maxaksel/HandTracker/README.md

# HandTracker

Project members: Max Bowman and Josh Stidham

This repository contains Eagle hardware files and C software files for
our final project.

Simulink navigation equation blocks used for visualization courtesy of Christopher Lum (University of Washington).
