maxaksel/HandTracker/eagle/HandTracker/HandTracker.brd

## EAGLE design eagle/HandTracker/HandTracker.brd (2022-04-10)

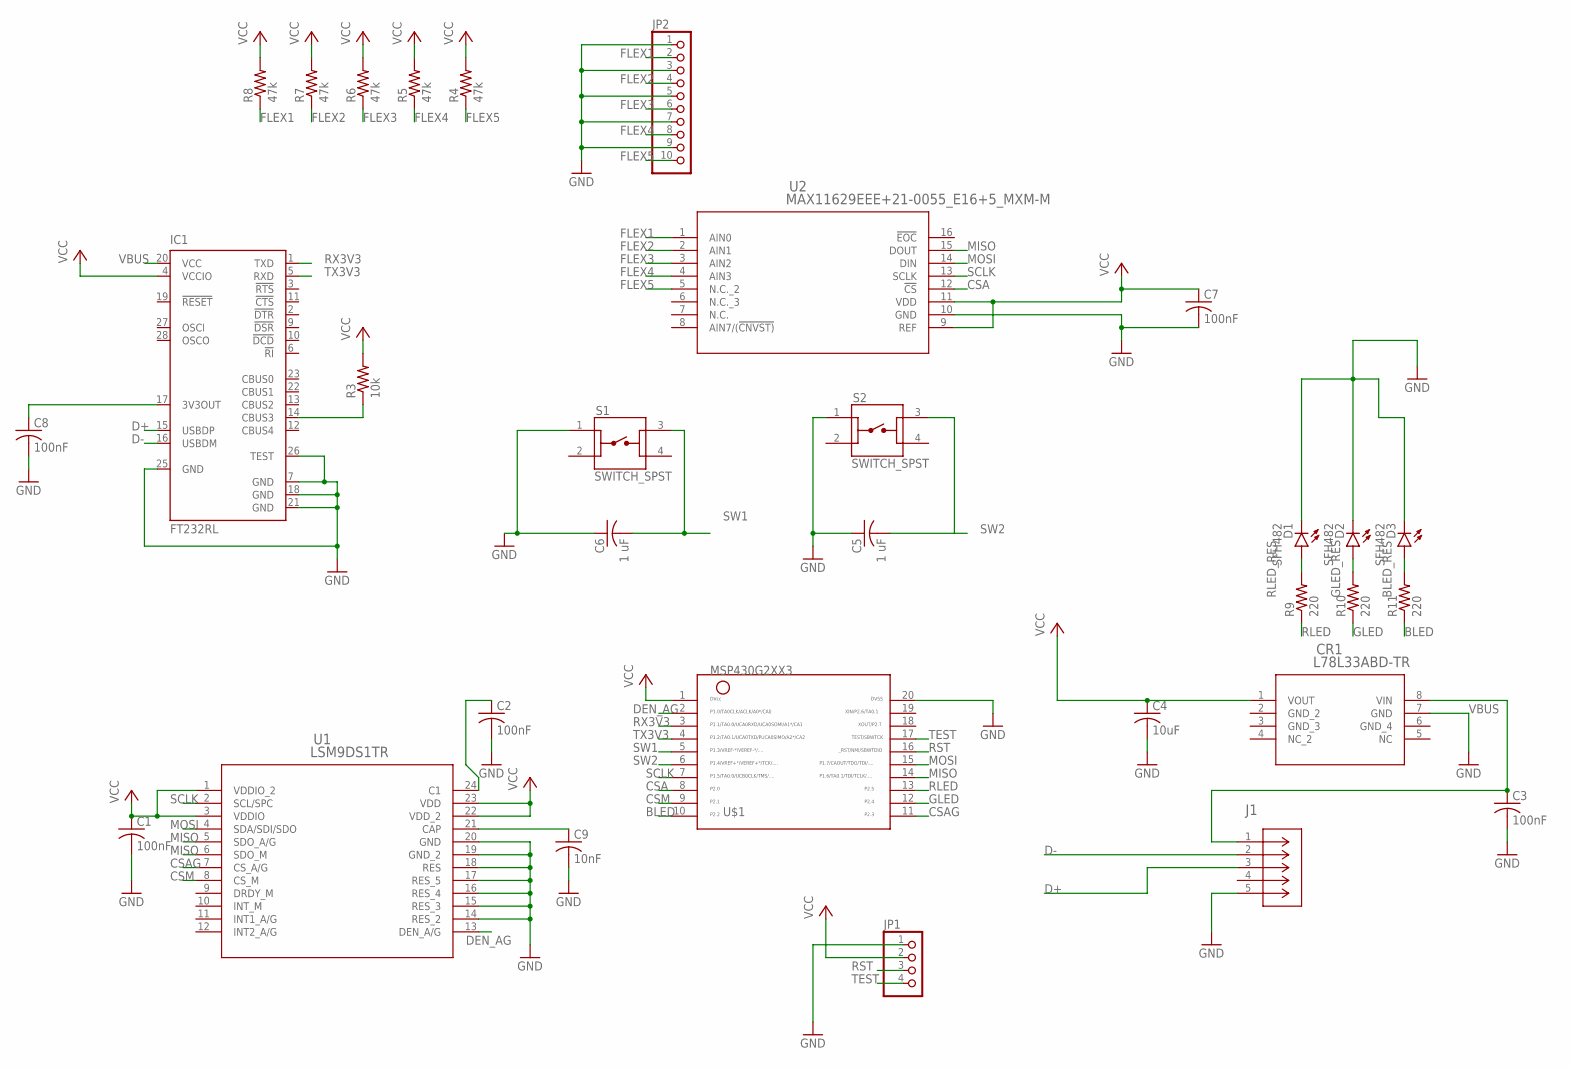
[picture p1: schematic HandTracker.sch]

Parts:
C1, C2, C3, C7, C8: 100nF; C1206
C4: 10uF; C1206
C5, C6: 1 uF; C1206
C9: 10nF; C1206
CR1: L78L33ABD-TR; SO-8_STM
D1, D2, D3: SFH482
IC1: FT232RL; SSOP28
J1: ZX62-AB-5PA(31); CONN5_ZX62-AB-5PA_HIR
JP1: PINHD-1X4/90; 1X04/90
JP2: PINHD-1X10; 1X10
R3: 10k; R1206
R4, R5, R6, R7, R8: 47k; R1206
R9, R10, R11: 220; R1206
S1, S2: SWITCH_SPST; SW_1825910-7
U1: LSM9DS1TR; LGA-24_3X3P5X1_STM
U2: MAX11629EEE+21-0055_E16+5_MXM-M; 21-0055_E16+5_MXM-M
U$1: MSP430G2XX3TSSOP; PW20

Connections:
BLED: R11.1, U$1.10
BLED_RES: D3.A, R11.2
CSA: U2.12 (!CS), U$1.8
CSAG: U1.7 (CS_A/G), U$1.11
CSM: U1.8 (CS_M), U$1.9
D+: IC1.15 (USBDP), J1.3 (D+)
D-: IC1.16 (USBDM), J1.2 (D-)
DEN_AG: U1.13 (DEN_A/G), U$1.2
FLEX1: JP2.2, R8.1, U2.1 (AIN0)
FLEX2: JP2.4, R7.1, U2.2 (AIN1)
FLEX3: JP2.6, R6.1, U2.3 (AIN2)
FLEX4: JP2.8, R5.1, U2.4 (AIN3)
FLEX5: JP2.10, R4.1, U2.5 (N.C._2)
GLED: R10.1, U$1.12
GLED_RES: D2.A, R10.2
GND: C1.2, C2.2, C3.2, C4.2, C5.1, C6.1, C7.2, C8.2, C9.2, CR1.7 (GND), D1.K (C), D2.K (C), D3.K (C), IC1.7 (GND), IC1.18 (GND), IC1.21 (GND), IC1.25 (GND), IC1.26 (TEST), J1.5 (GND), JP1.1, JP2.1, JP2.3, JP2.5, JP2.7, JP2.9, S1.1, S2.1, U1.14 (RES_2), U1.15 (RES_3), U1.16 (RES_4), U1.17 (RES_5), U1.18 (RES), U1.19 (GND_2), U1.20 (GND), U2.10 (GND), U$1.20
MISO: U1.5 (SDO_A/G), U1.6 (SDO_M), U2.15 (DOUT), U$1.14
MOSI: U1.4 (SDA/SDI/SDO), U2.14 (DIN), U$1.15
unnamed: C2.1, U1.24 (C1)
unnamed: C8.1, IC1.17 (3V3OUT)
unnamed: IC1.14 (CBUS3), R3.1
unnamed: C9.1, U1.21 (CAP)
RLED: R9.1, U$1.13
RLED_RES: D1.A, R9.2
RST: JP1.3, U$1.16
RX3V3: IC1.1 (TXD), U$1.3
SCLK: U1.2 (SCL/SPC), U2.13 (SCLK), U$1.7
SW1: C6.2, S1.3, U$1.5
SW2: C5.2, S2.3, U$1.6
TEST: JP1.4, U$1.17
TX3V3: IC1.5 (RXD), U$1.4
VBUS: C3.1, CR1.8 (VIN), IC1.20 (VCC), J1.1 (VCC)
VCC: C1.1, C4.1, C7.1, CR1.1 (VOUT), IC1.4 (VCCIO), JP1.2, R3.2, R4.2, R5.2, R6.2, R7.2, R8.2, U1.1 (VDDIO_2), U1.3 (VDDIO), U1.22 (VDD_2), U1.23 (VDD), U2.9 (REF), U2.11 (VDD), U$1.1

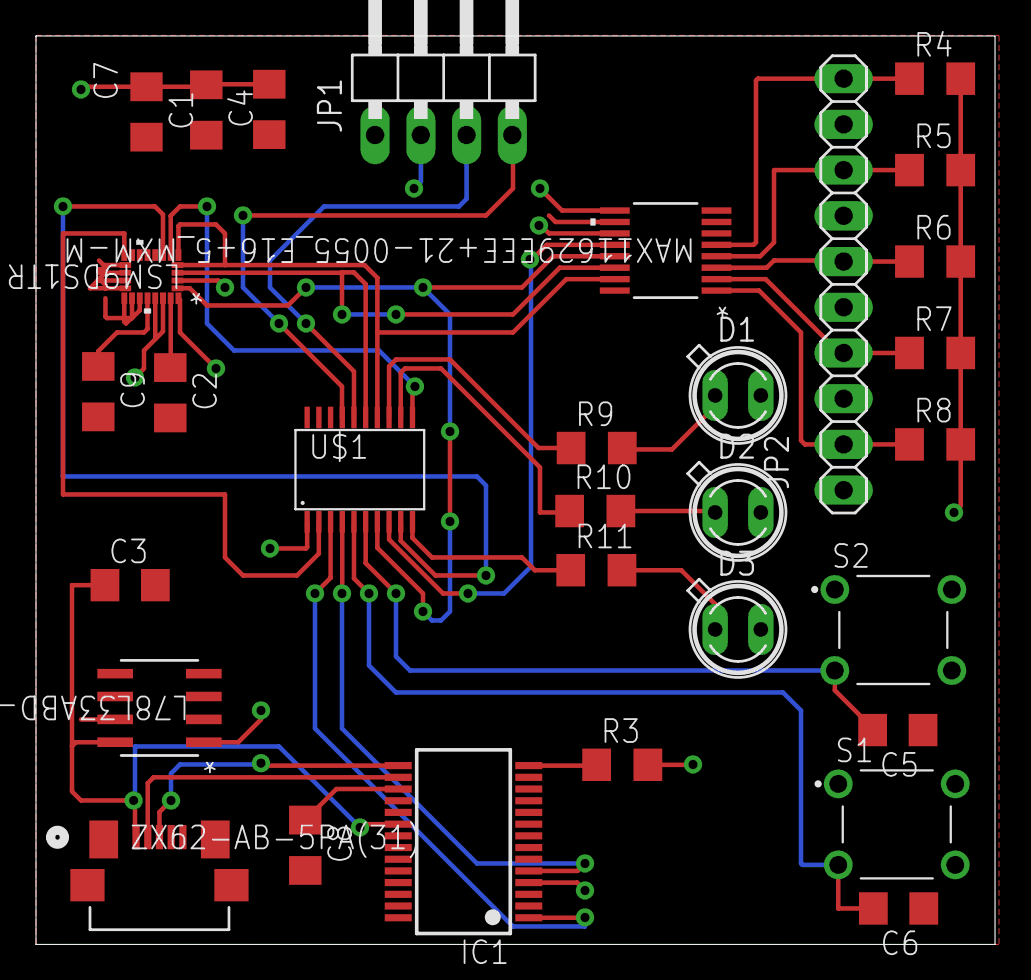
[picture p2: board HandTracker.brd from above]

Board: 2 copper layers, 53.3 x 50.5 mm, 31 parts (0 on the bottom side), 33 nets.
