maxaksel/HandTracker/serial.h

/*
 * serial.h
 *
 *  Created on: Apr 24, 2022
 *      Author: joshs
 */

#include <stdint.h>
#include <stdbool.h>
#include <msp430.h>

#include "spi.h"
#include "uart.h"


#ifndef SERIAL_H_
#define SERIAL_H_










#endif /* SERIAL_H_ */
