maxaksel/HandTracker/(commit log)

2022-04-04 Added Project Structure
    [HandTracker.sch]
2022-04-04 Started Adding Components to Schematic
    [HandTracker.sch]
2022-04-07 Started Populating Schematic with ICs
    [HandTracker.sch]
2022-04-07 Continued Populating Schematic and began making connections
    [HandTracker.sch]
2022-04-07 continued making connections
    [HandTracker.sch]
2022-04-07 completed connections for all components except FT232
    [HandTracker.sch]
2022-04-07 added FT232RL, still need to add LED
    [HandTracker.sch]
2022-04-08 added led, completed schematic
    [HandTracker.sch]
2022-04-08 updated passive component values to reflect recommended operating conditions for various ICs
    [HandTracker.sch]
2022-04-08 removed USB termination resistors
    [HandTracker.sch]
2022-04-08 Changed linear voltage regulator.
    [HandTracker.sch]
2022-04-08 Add board file.
    [HandTracker.brd]
2022-04-09 Board routing minus VDD and GND planes.
    [HandTracker.brd]
2022-04-09 Draft 1 PCB with GND and VCC planes.
    [HandTracker.brd]
2022-04-10 Fix LED and route planes.
    [HandTracker.brd, HandTracker.sch]
2022-04-10 replaced rgb led with three LEDs
    [HandTracker.sch]
2022-04-10 Routed LEDs and fixed clearance issues.
    [HandTracker.brd]
2022-04-10 Add machining files generated with CAM job.
    [HandTracker.GBL, HandTracker.GTL]
2022-04-11 Button and LED IO software.
2022-04-13 Timer A interrupt code.
2022-04-18 rough code with some basic SPI functions
2022-04-22 LSM9DS1 SPI code.
2022-04-23 added files for SPI, SYSTEM (for later use), test (also for later use)
2022-04-24 updated spi API to be clearer, added uart files. Both untested
2022-04-24 Fixed + tested SPI async functions
    [main.c, spi.c, spi.h, uart.c, uart.h]
2022-04-24 minor changes to UART API, need to make more significant changes to structure of Interrupt handlers
2022-04-24 added two spi functions to switc between ADC + LSM9DS1, tested with main
2022-04-25 created serial file with combined UART + SPI ISRs, tested UART with FTDI232 chip
2022-04-28 UC0 RX Interrupt now declares SPI transmission to be complete if buffer is overrun
2022-04-28 Flight simulator and MATLAB read code. LSM9DS1 and resistor ADC code.
2022-04-29 began implementing main.c, modified timer code for use in this device (removed SW divider), changed SPI, UART baud rates, and modified button code for polling
2022-04-29 updated resistor function prototypes and continued system integration in main.c
2022-04-29 Matlab sensor fusion update.
2022-04-29 added volatile keyword to global vars modified by interrupts
2022-04-29 Add sensor fusion algorithm. Add custom glove Simulink block.
2022-04-29 Modified code to read resistors in MATLAB from packet properly
2022-04-30 reimplemented Kalman filter
2022-04-30 fixed timing, LEDs, and got Kalman filter working in MATLAB
    [led.c, timera0.c]
2022-05-01 Add IMU calibration mats. Add magnetometer support. Simulink data block.
2022-05-02 Fixed Magnetometer
2022-05-02 fixed compiler warnings related to casting volitile to nonvolatile variable with cast
    [resistor.c, uart.c]
